poppnn/minikb/enclosure/variants/2_touches_batterie/png/back_usb.png

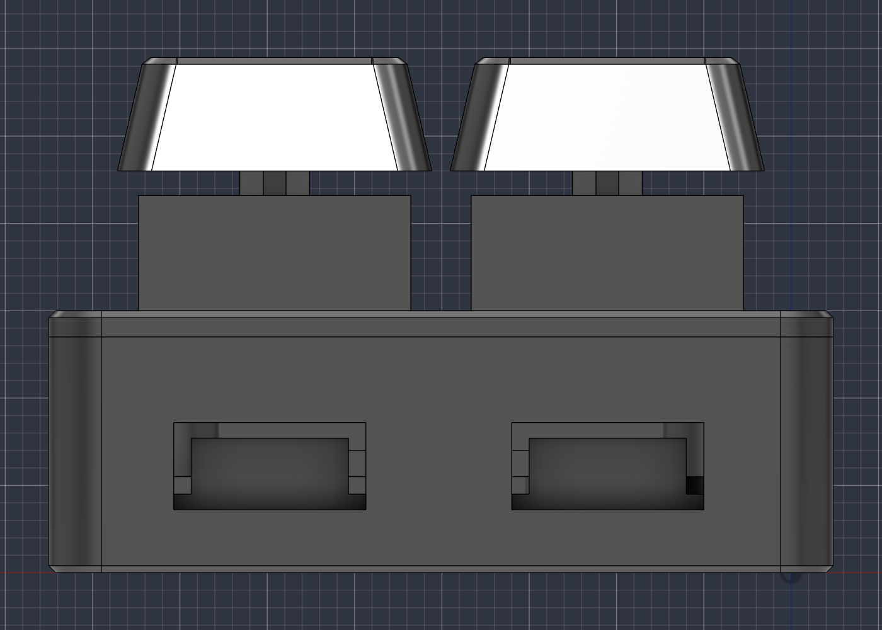
enclosure/variants/2_touches_batterie/png/back_usb.png
