poppnn/minikb/enclosure/variants/2_touches_batterie/png/bottom.png

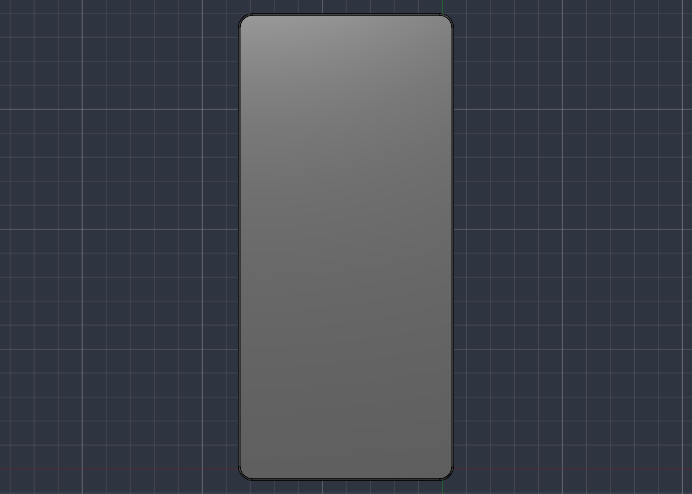
enclosure/variants/2_touches_batterie/png/bottom.png
