poppnn/minikb/enclosure/variants/2_touches_batterie/png/case_inside_iso.png

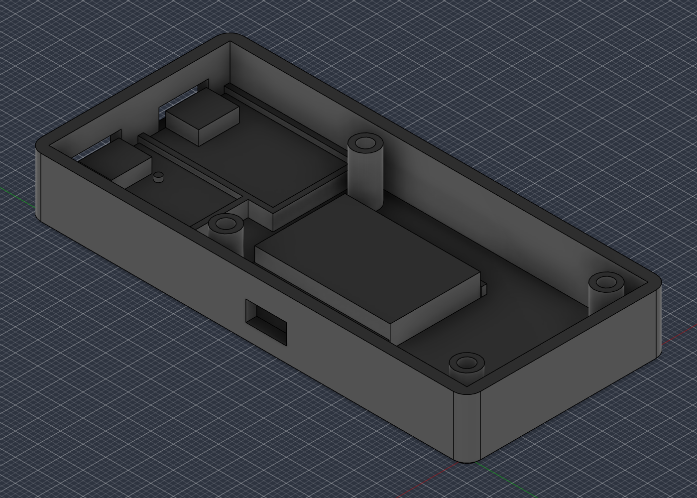
enclosure/variants/2_touches_batterie/png/case_inside_iso.png
