poppnn/minikb/enclosure/variants/2_touches_batterie/png/exploded_iso.png

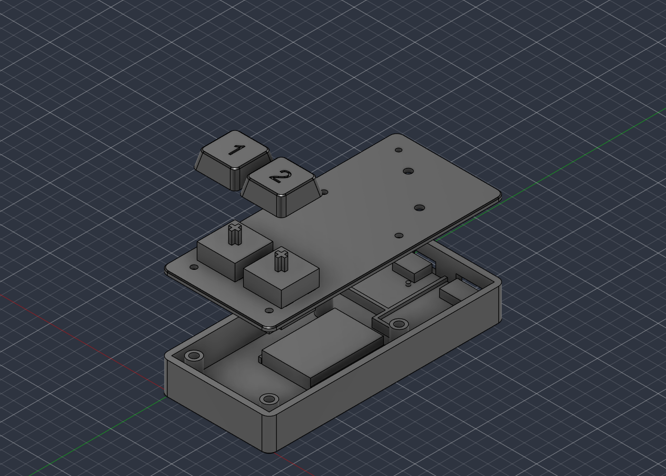
enclosure/variants/2_touches_batterie/png/exploded_iso.png
