poppnn/minikb/enclosure/variants/4_touches/png/back_usb.png

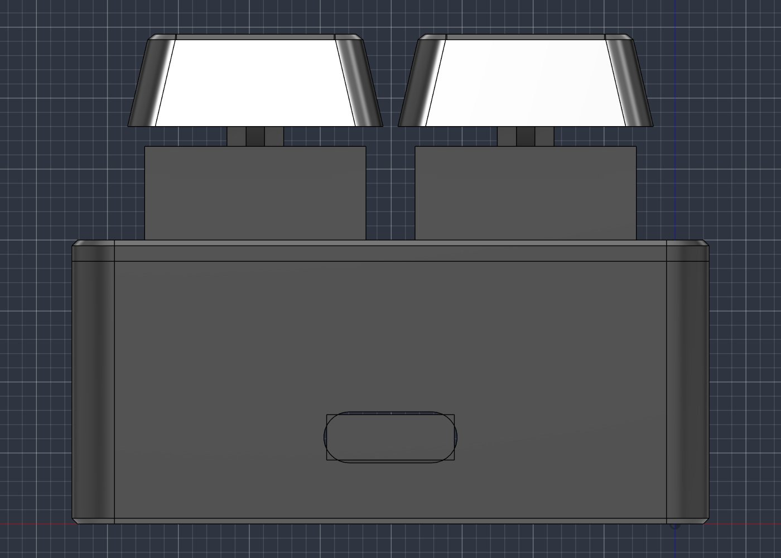
enclosure/variants/4_touches/png/back_usb.png
