poppnn/minikb/enclosure/variants/4_touches/png/bottom.png

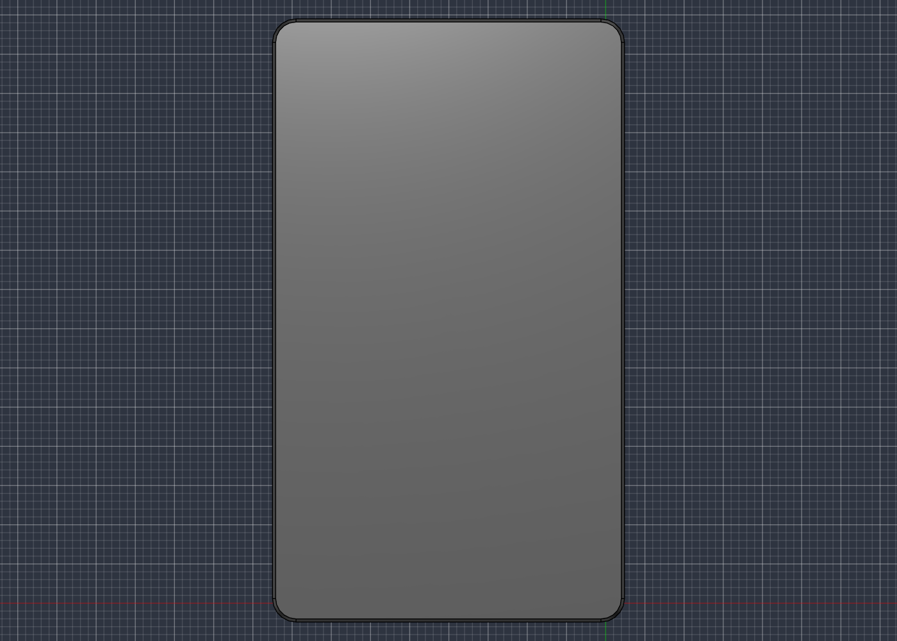
enclosure/variants/4_touches/png/bottom.png
