poppnn/minikb/enclosure/variants/4_touches/png/case_inside_top.png

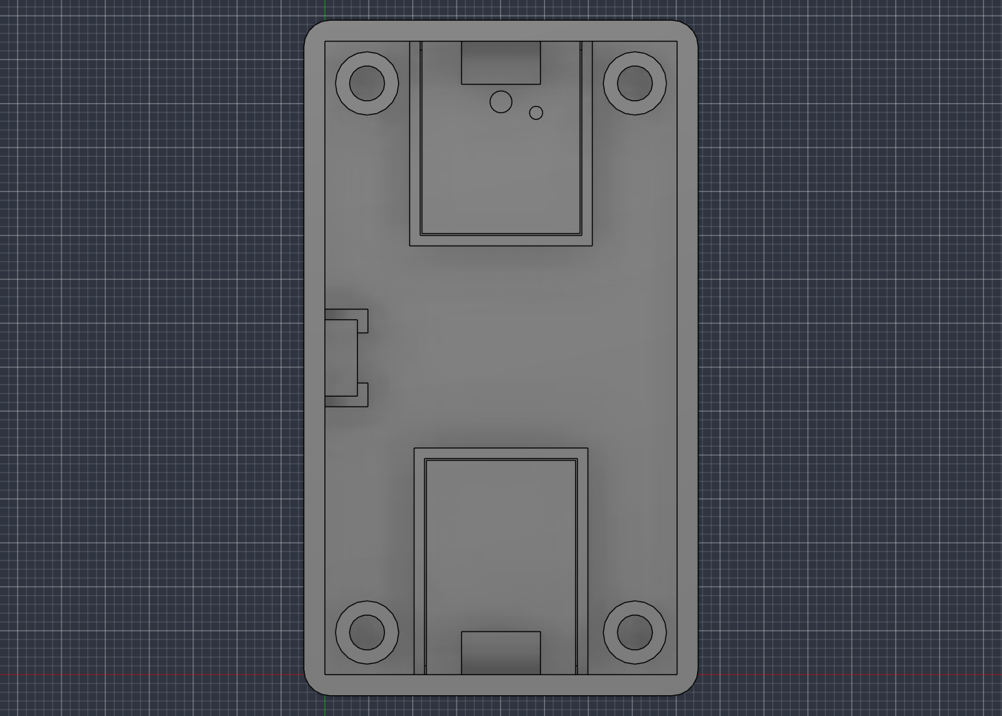
enclosure/variants/4_touches/png/case_inside_top.png
