poppnn/minikb/enclosure/variants/4_touches/png/exploded_iso.png

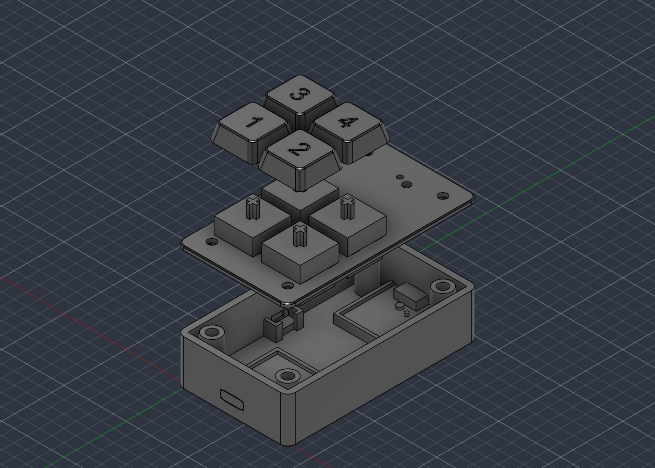
enclosure/variants/4_touches/png/exploded_iso.png
