poppnn/minikb/enclosure/variants/4_touches/png/top.png

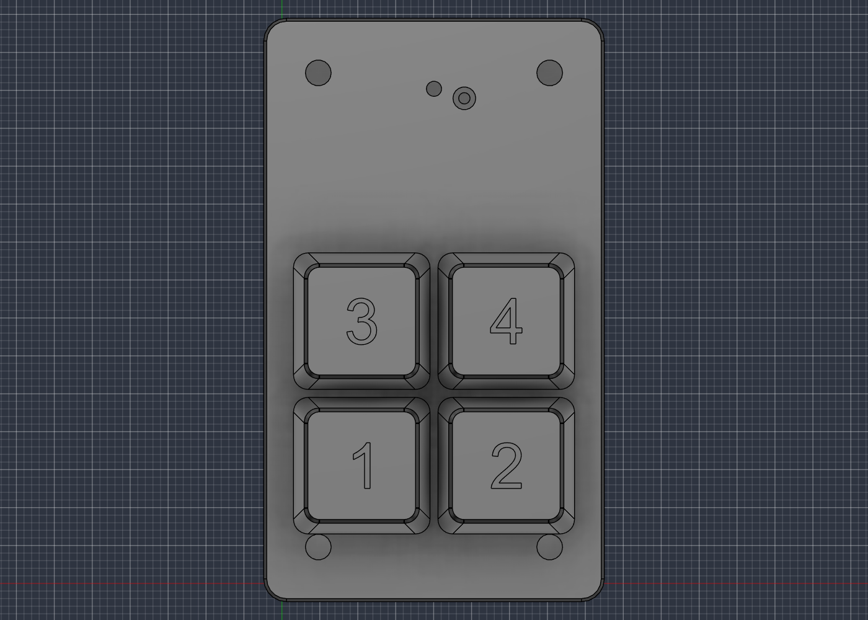
enclosure/variants/4_touches/png/top.png
