poppnn/minikb/enclosure/variants/4_touches_batterie/png/case_inside_iso.png

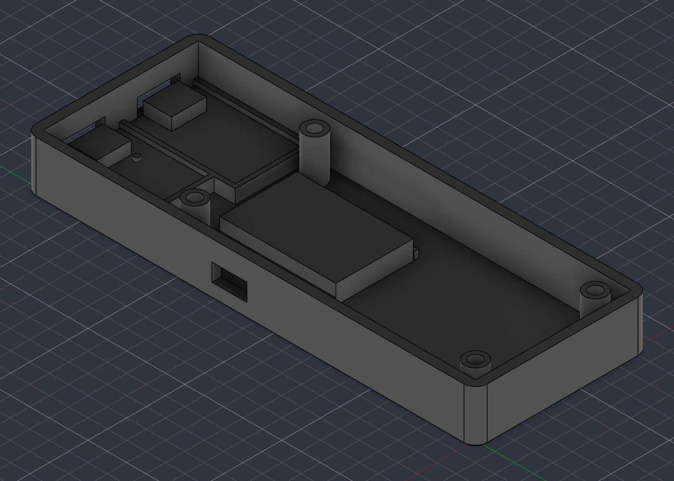
enclosure/variants/4_touches_batterie/png/case_inside_iso.png
