poppnn/minikb/enclosure/variants/4_touches_batterie/png/exploded_iso.png

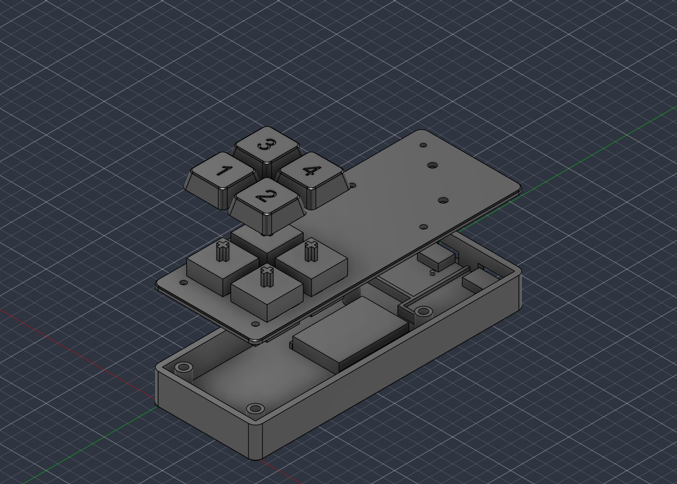
enclosure/variants/4_touches_batterie/png/exploded_iso.png
