poppnn/minikb/enclosure/variants/6_touches_batterie/png/case_inside_iso.png

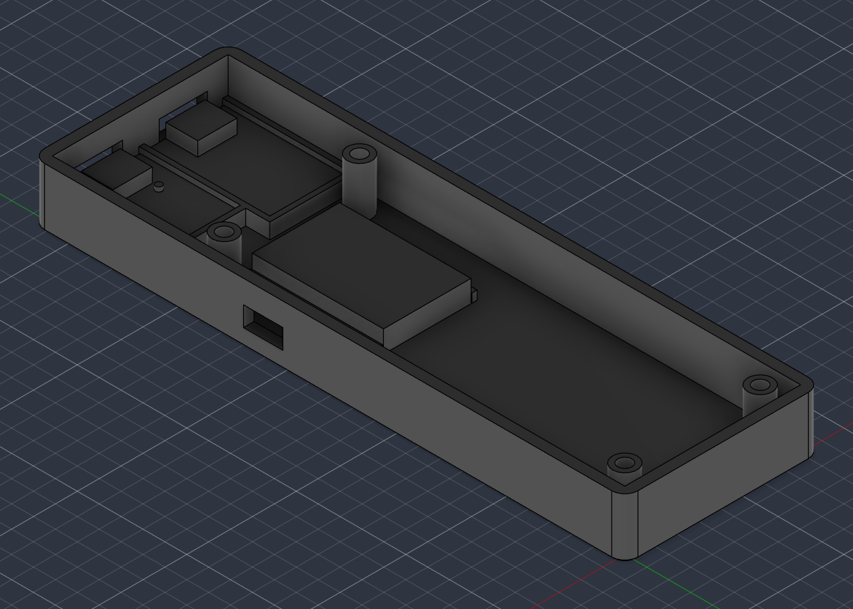
enclosure/variants/6_touches_batterie/png/case_inside_iso.png
