poppnn/minikb/enclosure/variants/6_touches_batterie/png/exploded_iso.png

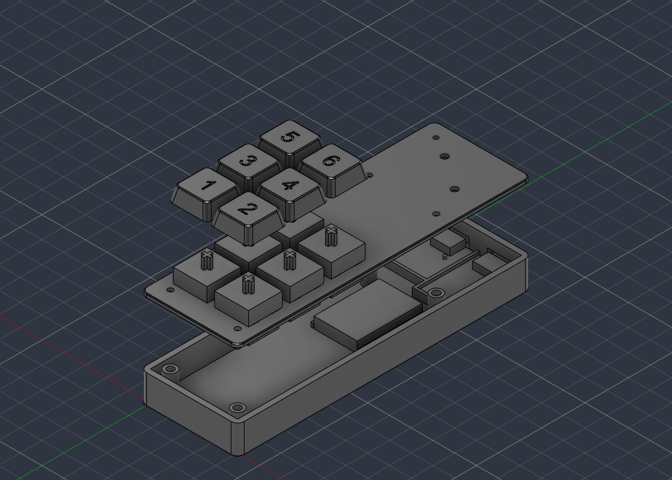
enclosure/variants/6_touches_batterie/png/exploded_iso.png
