poppnn/minikb/enclosure/variants/8_touches_batterie/png/case_inside_iso.png

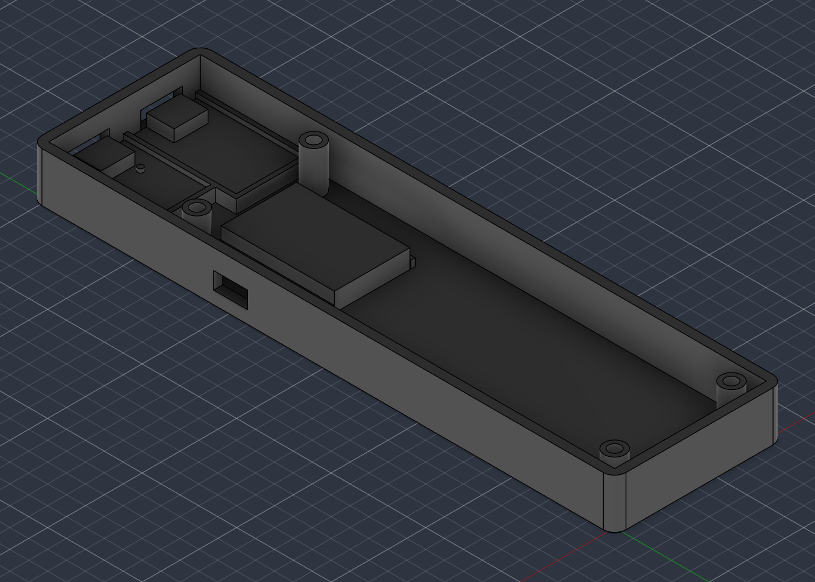
enclosure/variants/8_touches_batterie/png/case_inside_iso.png
