poppnn/minikb/enclosure/variants/8_touches_batterie/png/exploded_iso.png

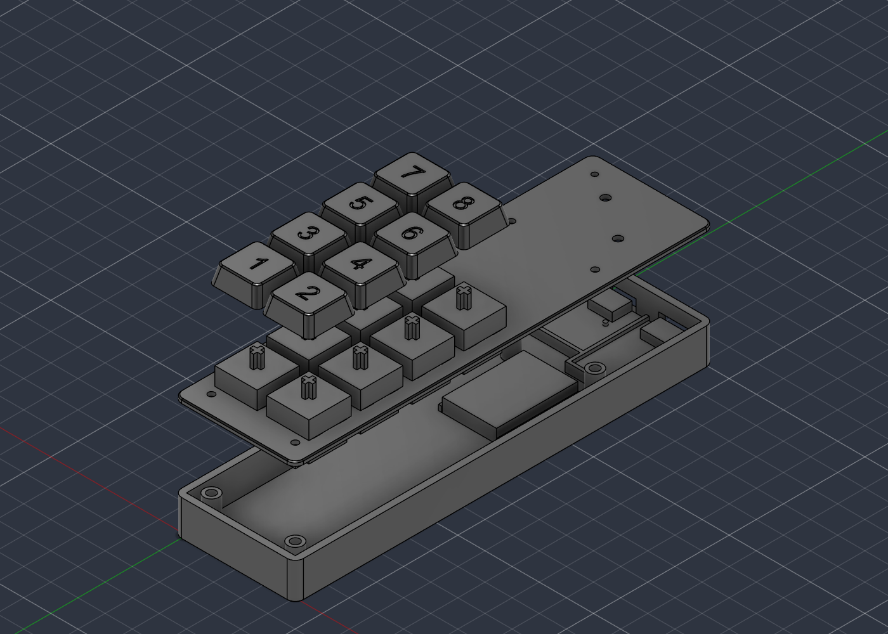
enclosure/variants/8_touches_batterie/png/exploded_iso.png
