poppnn/minikb/enclosure/stl/assembly.stl

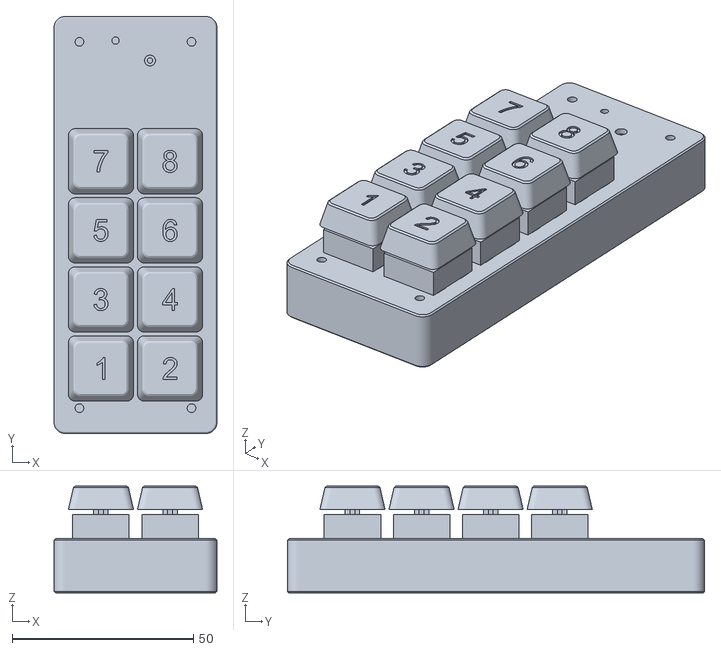
[picture p17: CAD file, 2026-11-04]
enclosure/stl/assembly.stl
44.9 x 115.0 x 29.5
