poppnn/minikb/enclosure/variants/4_touches/stl/assembly.stl

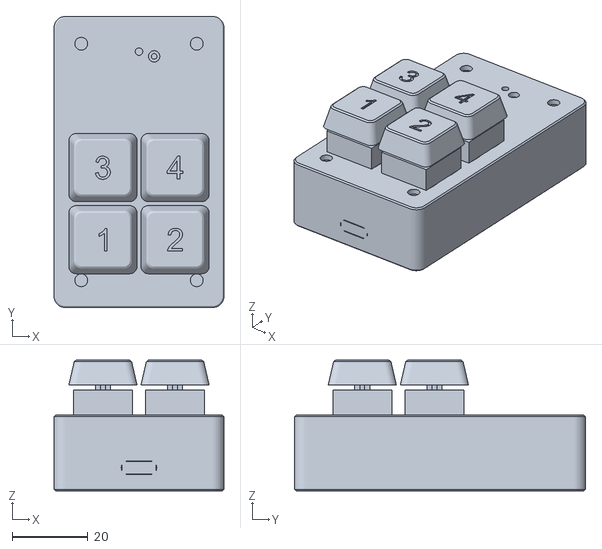
[picture p18: CAD file, 2026-11-05]
enclosure/variants/4_touches/stl/assembly.stl
44.9 x 76.9 x 34.5
