poppnn/minikb/enclosure/variants/6_touches_batterie/stl/assembly.stl

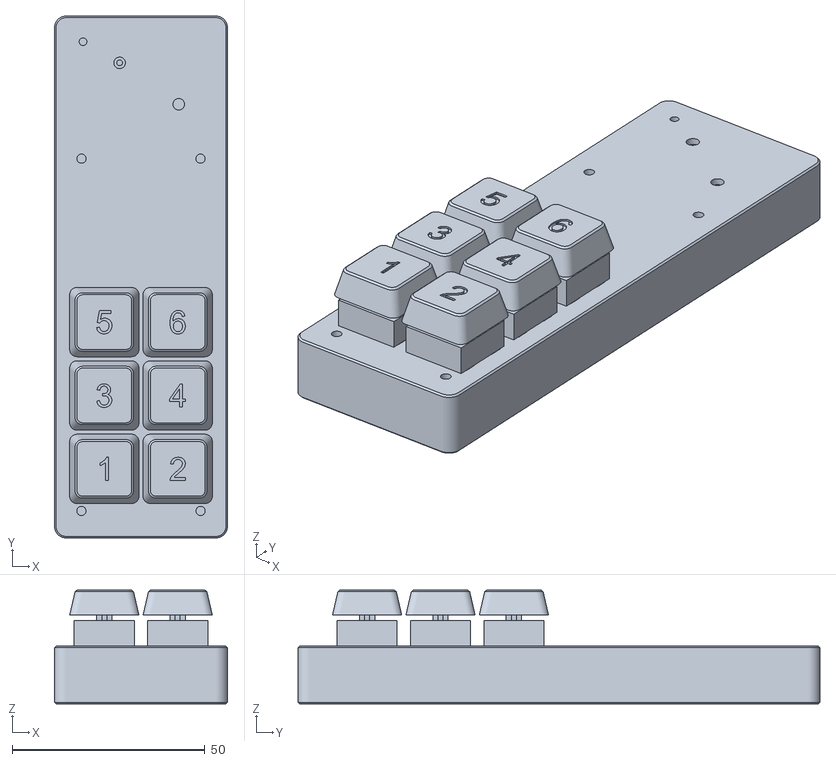
[picture p19: CAD file, 2026-11-04]
enclosure/variants/6_touches_batterie/stl/assembly.stl
44.9 x 135.5 x 29.5
