poppnn/minikb/enclosure/variants/2_touches/stl/assembly.stl

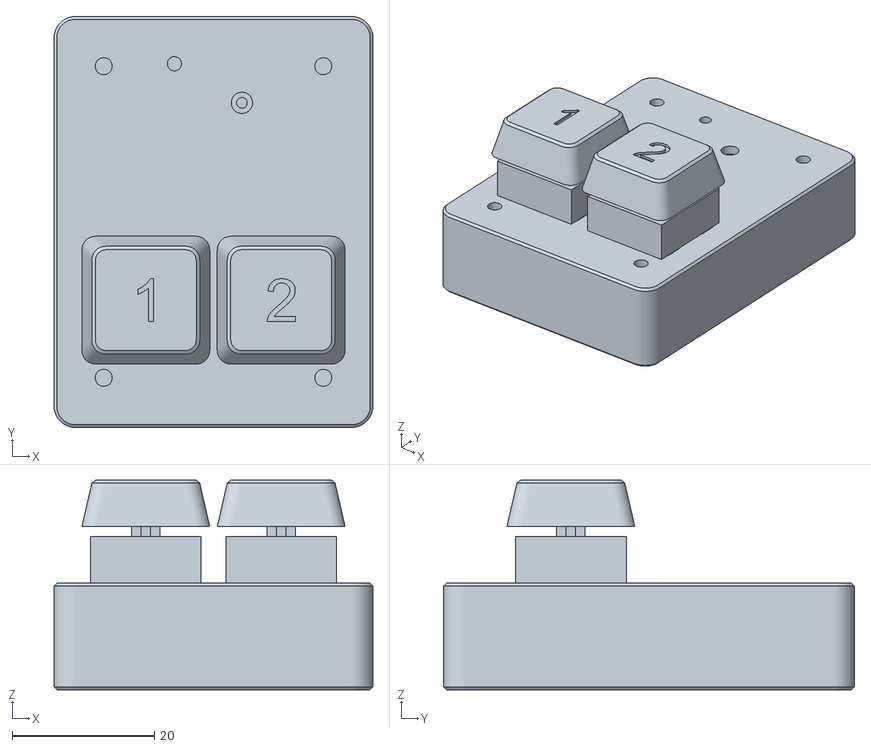
[picture p20: CAD file, 2026-11-04]
enclosure/variants/2_touches/stl/assembly.stl
44.9 x 57.9 x 29.5
