poppnn/minikb/enclosure/variants/2_touches_batterie/stl/assembly.stl

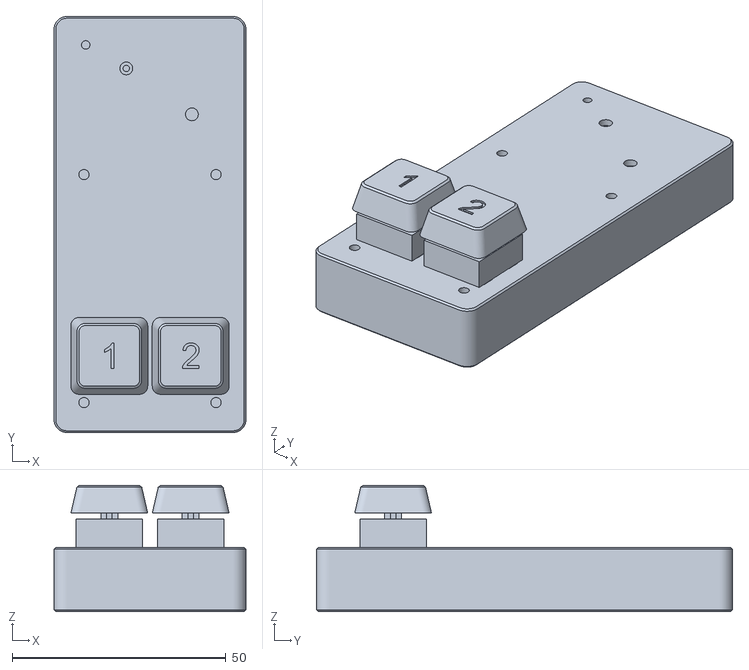
[picture p21: CAD file, 2026-11-04]
enclosure/variants/2_touches_batterie/stl/assembly.stl
44.9 x 97.3 x 29.5
