poppnn/minikb/enclosure/variants/6_touches/stl/assembly.stl

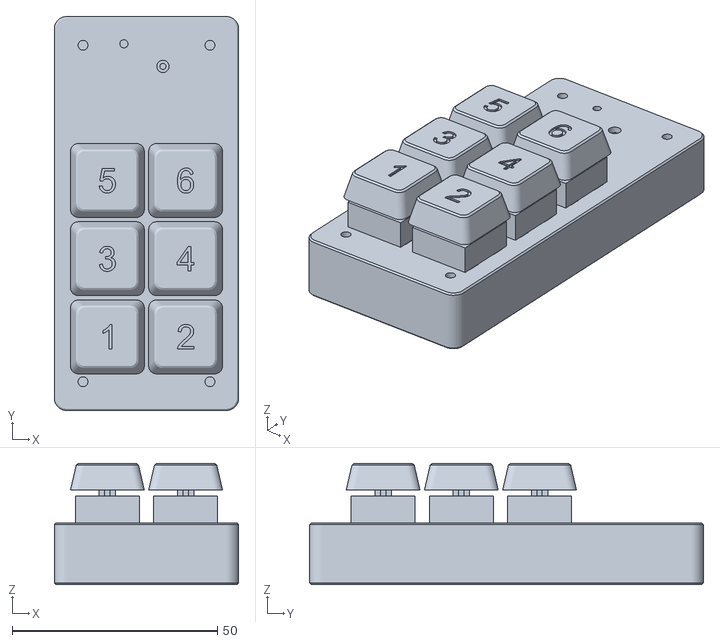
[picture p22: CAD file, 2026-11-04]
enclosure/variants/6_touches/stl/assembly.stl
44.9 x 96.0 x 29.5
