poppnn/minikb/enclosure/variants/8_touches_batterie/stl/assembly.stl

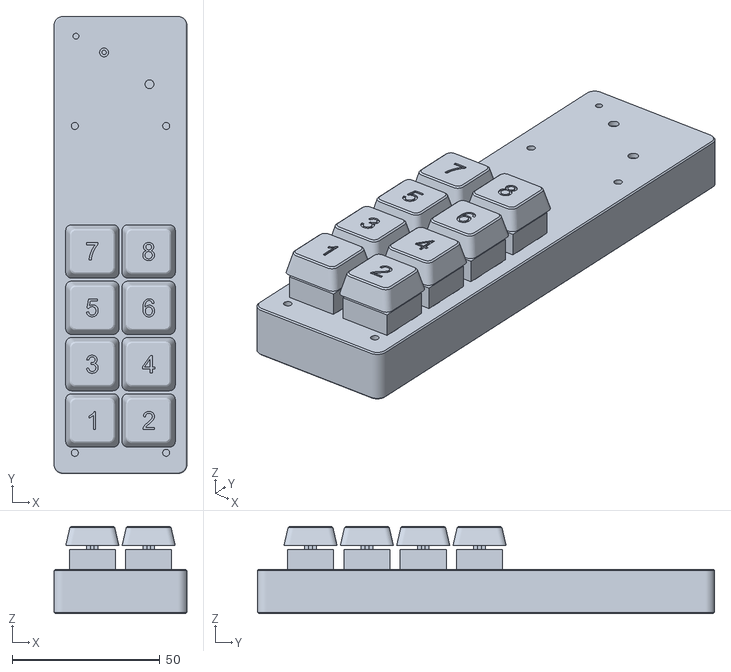
[picture p23: CAD file, 2026-11-04]
enclosure/variants/8_touches_batterie/stl/assembly.stl
44.9 x 154.5 x 29.5
