poppnn/minikb/enclosure/variants/4_touches_batterie/stl/assembly.stl

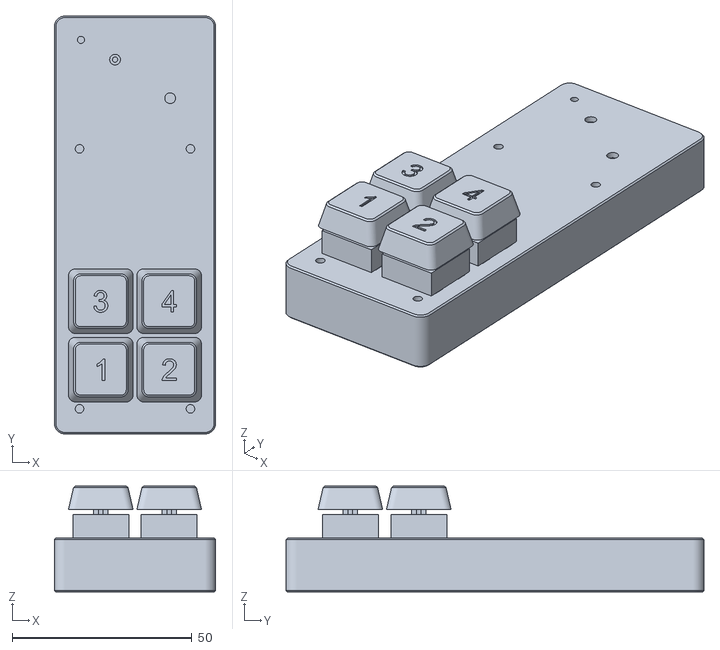
[picture p24: CAD file, 2026-11-04]
enclosure/variants/4_touches_batterie/stl/assembly.stl
44.9 x 116.4 x 29.5
