poppnn/minikb/enclosure/variants/2_touches_batterie/stl/case.stl

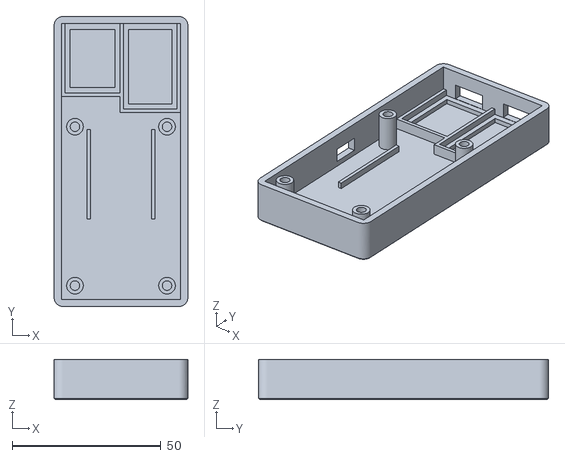
[picture p25: CAD file, 2026-11-04]
enclosure/variants/2_touches_batterie/stl/case.stl
44.9 x 97.3 x 13.5
