poppnn/minikb/enclosure/variants/4_touches/stl/plate.stl

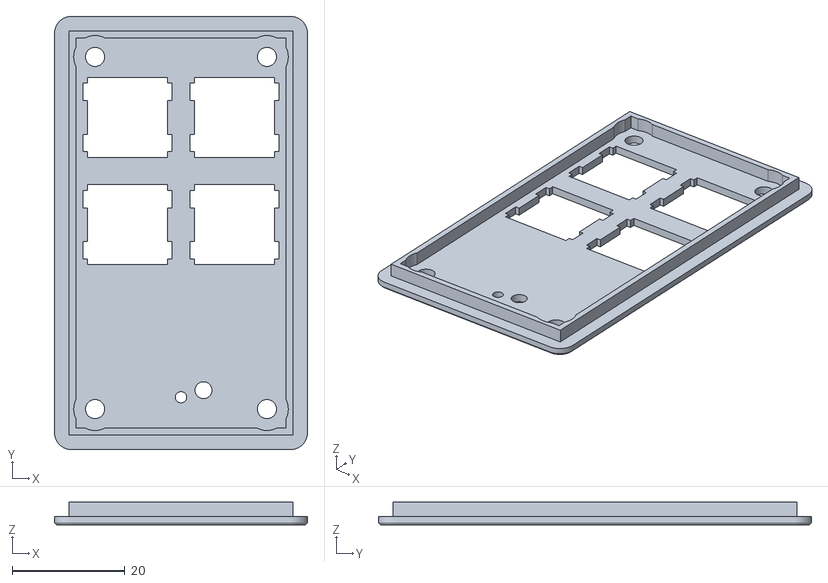
[picture p26: CAD file, 2026-11-05]
enclosure/variants/4_touches/stl/plate.stl
44.9 x 76.9 x 4.00
