poppnn/minikb/enclosure/variants/4_touches_batterie/stl/plate.stl

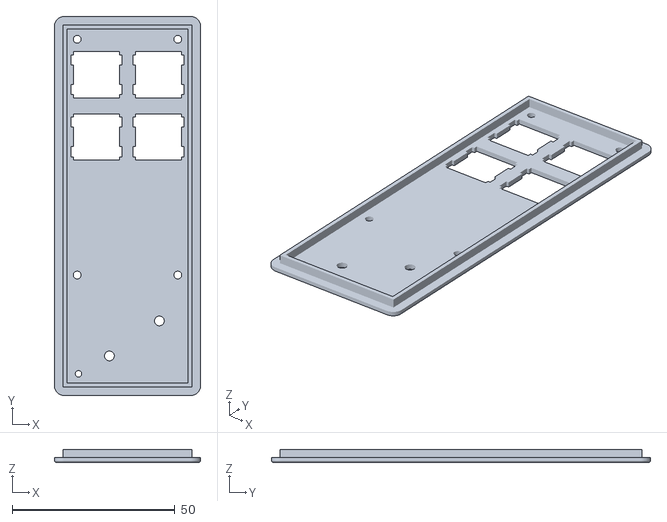
[picture p27: CAD file, 2026-11-04]
enclosure/variants/4_touches_batterie/stl/plate.stl
44.9 x 116.4 x 4.00
