poppnn/minikb/enclosure/variants/6_touches_batterie/stl/keycap_6.stl

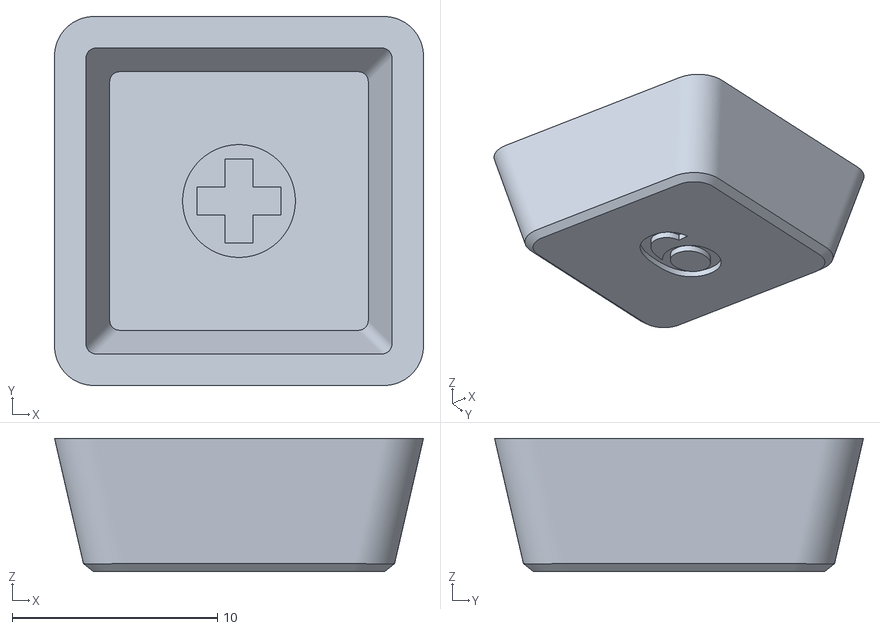
[picture p28: CAD file, 2026-11-04]
enclosure/variants/6_touches_batterie/stl/keycap_6.stl
18.0 x 18.0 x 6.50
