poppnn/minikb/enclosure/variants/4_touches/stl/case.stl

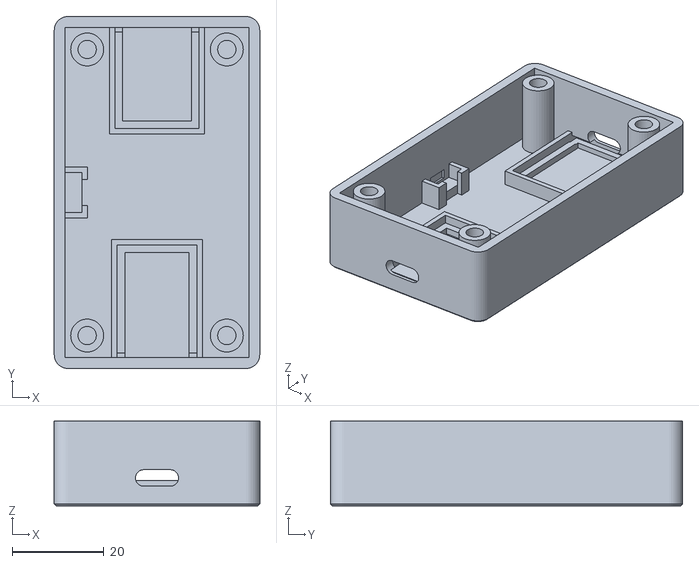
[picture p29: CAD file, 2026-11-05]
enclosure/variants/4_touches/stl/case.stl
44.9 x 76.9 x 18.5
