poppnn/minikb/enclosure/variants/2_touches_batterie/stl/plate.stl

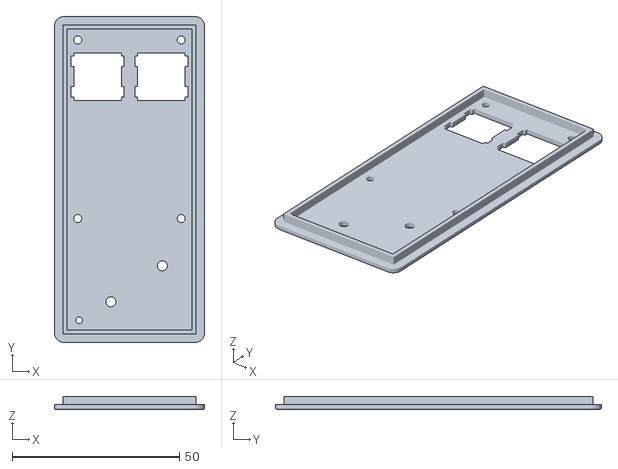
[picture p30: CAD file, 2026-11-04]
enclosure/variants/2_touches_batterie/stl/plate.stl
44.9 x 97.3 x 4.00
