poppnn/minikb/enclosure/variants/2_touches_batterie/stl/keycap_2u.stl

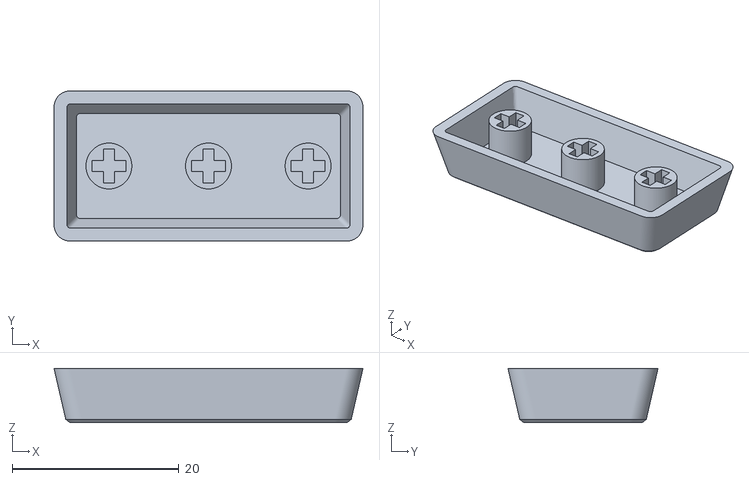
[picture p31: CAD file, 2026-11-04]
enclosure/variants/2_touches_batterie/stl/keycap_2u.stl
37.0 x 18.0 x 6.50
