poppnn/minikb/enclosure/variants/8_touches_batterie/stl/case.stl

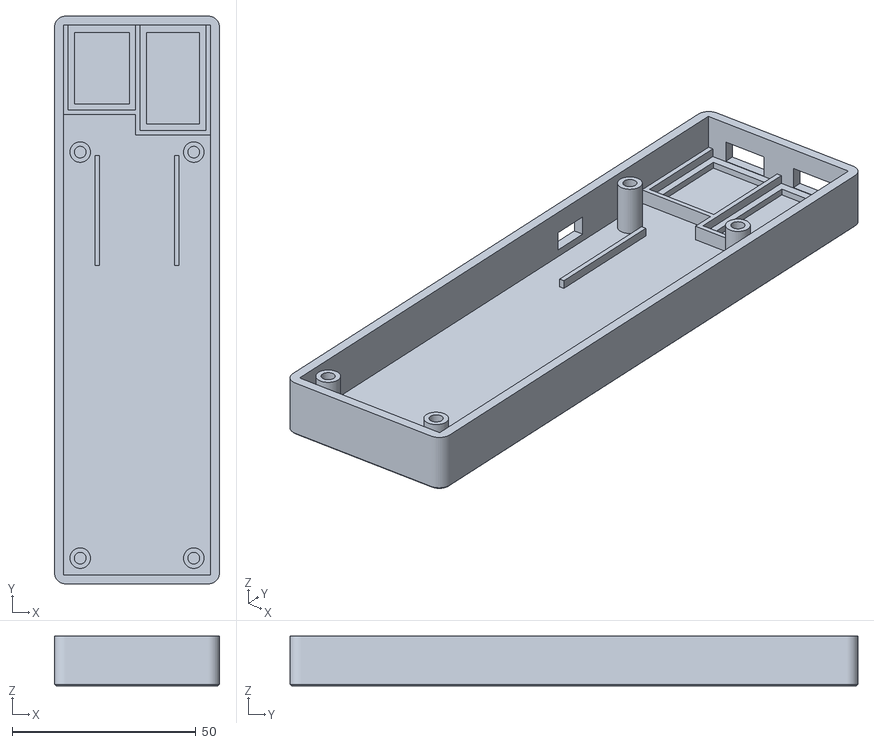
[picture p32: CAD file, 2026-11-04]
enclosure/variants/8_touches_batterie/stl/case.stl
44.9 x 154.5 x 13.5
