poppnn/minikb/enclosure/variants/4_touches_batterie/stl/case.stl

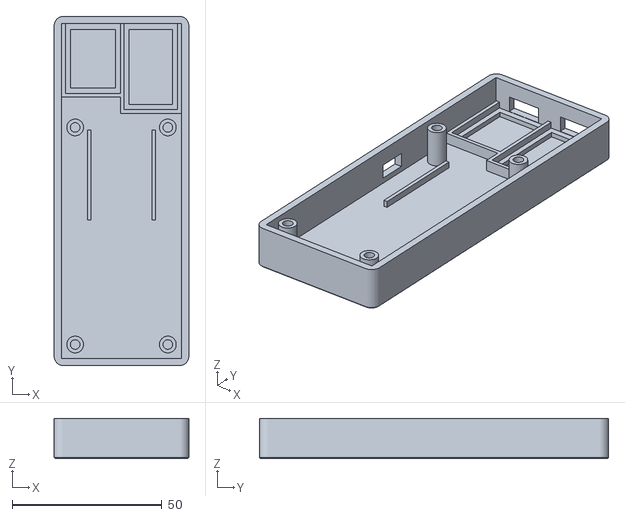
[picture p33: CAD file, 2026-11-04]
enclosure/variants/4_touches_batterie/stl/case.stl
44.9 x 116.4 x 13.5
