poppnn/minikb/enclosure/variants/6_touches_batterie/stl/case.stl

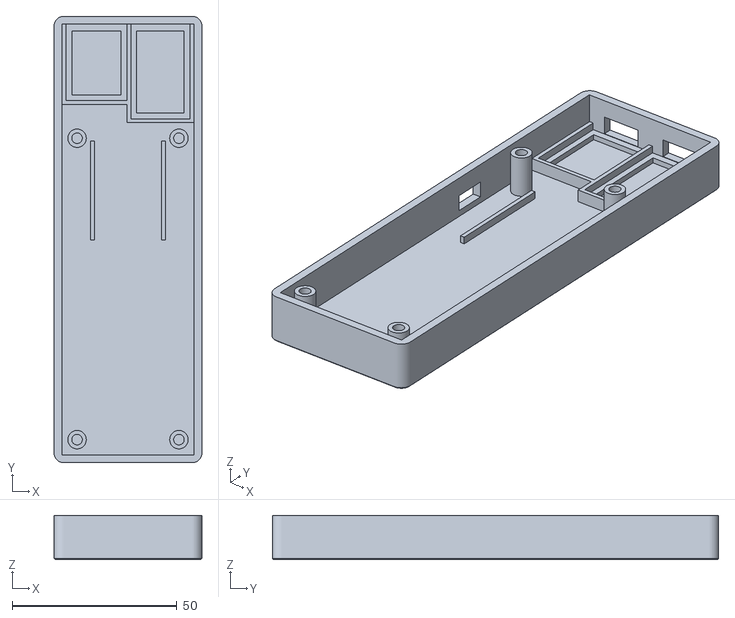
[picture p34: CAD file, 2026-11-04]
enclosure/variants/6_touches_batterie/stl/case.stl
44.9 x 135.4 x 13.5
