poppnn/minikb/enclosure/variants/8_touches_batterie/stl/plate.stl

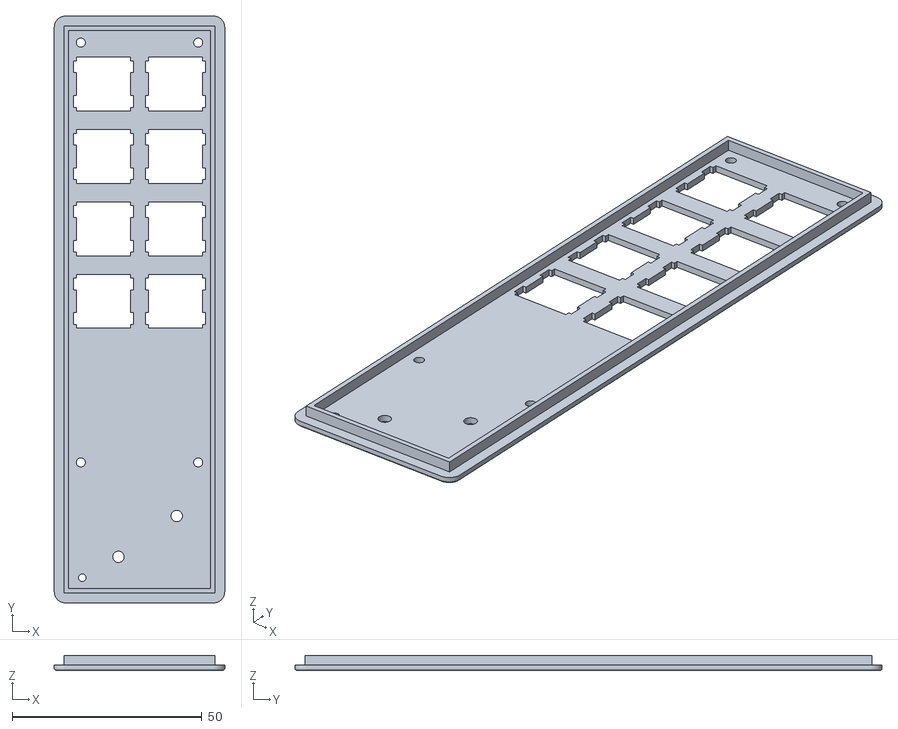
[picture p35: CAD file, 2026-11-04]
enclosure/variants/8_touches_batterie/stl/plate.stl
44.9 x 154.5 x 4.00
