poppnn/minikb/enclosure/variants/6_touches_batterie/stl/plate.stl

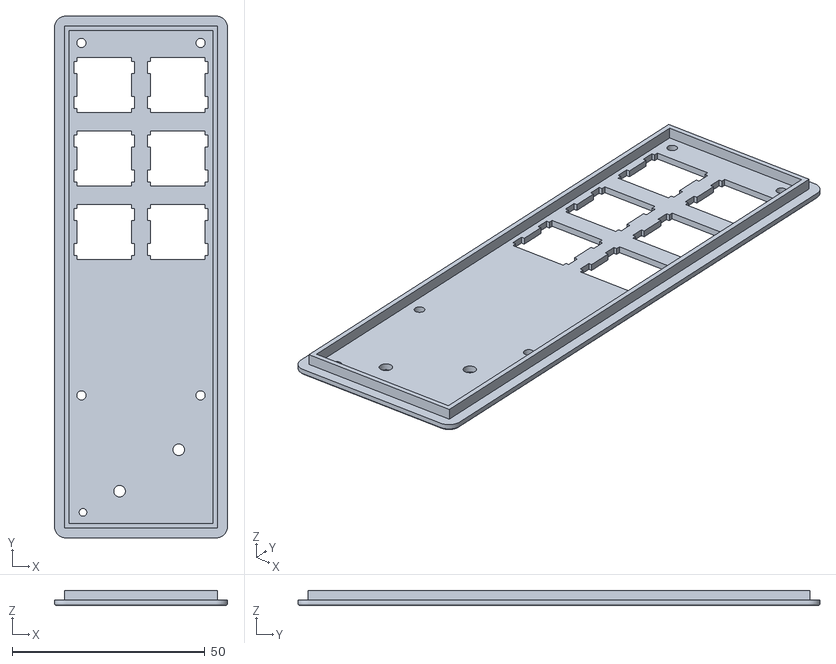
[picture p36: CAD file, 2026-11-04]
enclosure/variants/6_touches_batterie/stl/plate.stl
44.9 x 135.4 x 4.00
