poppnn/minikb/(list of files, cad)

Other CAD files:
enclosure/variants/8_touches_batterie/stl/keycap_5.stl
enclosure/variants/2_touches_batterie/stl/keycap_1.stl
enclosure/variants/4_touches_batterie/stl/keycap_1.stl
enclosure/variants/6_touches_batterie/stl/keycap_5.stl
enclosure/variants/8_touches_batterie/stl/keycap_3.stl
enclosure/variants/4_touches_batterie/stl/keycap_4.stl
enclosure/variants/6_touches_batterie/stl/keycap_1.stl
enclosure/variants/8_touches_batterie/stl/keycap_2.stl
enclosure/variants/4_touches/stl/keycap_3.stl
enclosure/variants/4_touches/stl/keycap_1.stl
enclosure/variants/4_touches_batterie/stl/keycap_2.stl
enclosure/variants/6_touches_batterie/stl/keycap_4.stl
enclosure/variants/2_touches_batterie/stl/keycap_2.stl
enclosure/variants/4_touches/stl/keycap_2u.stl
enclosure/variants/4_touches_batterie/stl/keycap_3.stl
enclosure/variants/6_touches_batterie/stl/keycap_2.stl
enclosure/variants/4_touches/stl/keycap_4.stl
enclosure/variants/6_touches_batterie/stl/keycap_3.stl
enclosure/variants/8_touches_batterie/stl/keycap_8.stl
enclosure/variants/4_touches/stl/keycap_2.stl
enclosure/variants/8_touches_batterie/stl/keycap_4.stl
enclosure/variants/8_touches_batterie/stl/keycap_1.stl
enclosure/variants/8_touches_batterie/stl/keycap_7.stl
enclosure/minikb.f3d
enclosure/stl/case.stl
enclosure/stl/keycap_1.stl
enclosure/stl/keycap_2.stl
enclosure/stl/keycap_2u.stl
enclosure/stl/keycap_3.stl
enclosure/stl/keycap_4.stl
enclosure/stl/keycap_5.stl
enclosure/stl/keycap_6.stl
enclosure/stl/keycap_7.stl
enclosure/stl/keycap_8.stl
enclosure/stl/plate.stl
enclosure/variants/2_touches/stl/case.stl
enclosure/variants/2_touches/stl/keycap_1.stl
enclosure/variants/2_touches/stl/keycap_2.stl
enclosure/variants/2_touches/stl/keycap_2u.stl
enclosure/variants/2_touches/stl/plate.stl
enclosure/variants/6_touches/stl/case.stl
enclosure/variants/6_touches/stl/keycap_1.stl
enclosure/variants/6_touches/stl/keycap_2.stl
enclosure/variants/6_touches/stl/keycap_2u.stl
enclosure/variants/6_touches/stl/keycap_3.stl
enclosure/variants/6_touches/stl/keycap_4.stl
enclosure/variants/6_touches/stl/keycap_5.stl
enclosure/variants/6_touches/stl/keycap_6.stl
enclosure/variants/6_touches/stl/plate.stl
enclosure/variants/8_touches/stl/case.stl
enclosure/variants/8_touches/stl/keycap_1.stl
enclosure/variants/8_touches/stl/keycap_2.stl
enclosure/variants/8_touches/stl/keycap_2u.stl
enclosure/variants/8_touches/stl/keycap_3.stl
enclosure/variants/8_touches/stl/keycap_4.stl
enclosure/variants/8_touches/stl/keycap_5.stl
enclosure/variants/8_touches/stl/keycap_6.stl
enclosure/variants/8_touches/stl/keycap_7.stl
enclosure/variants/8_touches/stl/keycap_8.stl
enclosure/variants/8_touches/stl/plate.stl
