poppnn/minikb/enclosure/variants/2_touches_batterie/png/assembly_iso.png

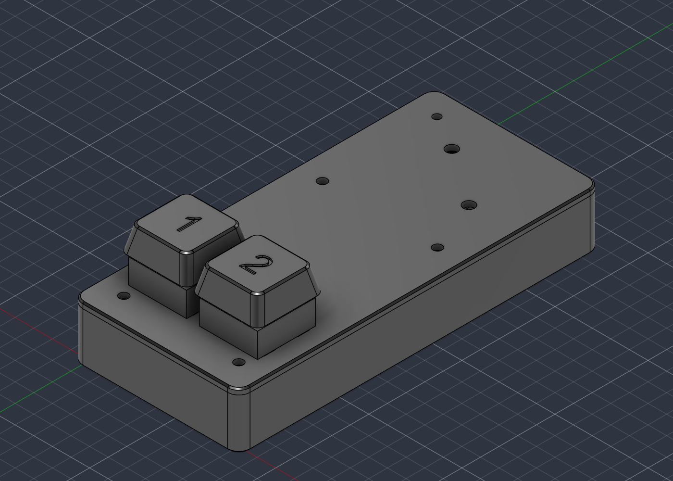
enclosure/variants/2_touches_batterie/png/assembly_iso.png
