poppnn/minikb/enclosure/variants/4_touches/png/assembly_iso.png

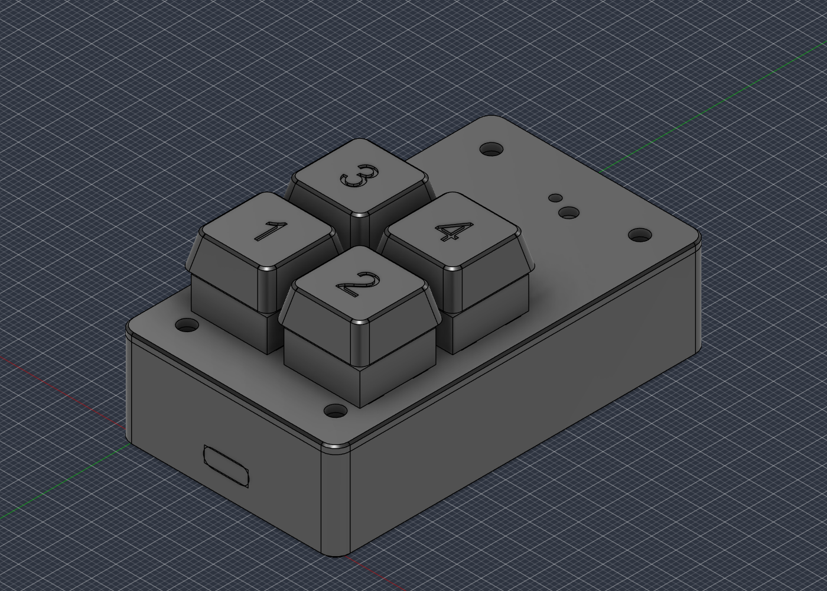
enclosure/variants/4_touches/png/assembly_iso.png
