poppnn/minikb/enclosure/variants/4_touches_batterie/png/assembly_iso.png

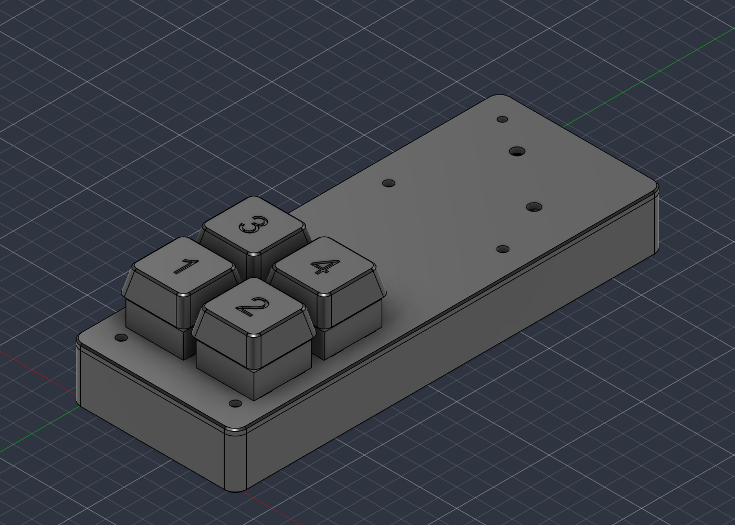
enclosure/variants/4_touches_batterie/png/assembly_iso.png
