poppnn/minikb/enclosure/variants/6_touches_batterie/png/assembly_iso.png

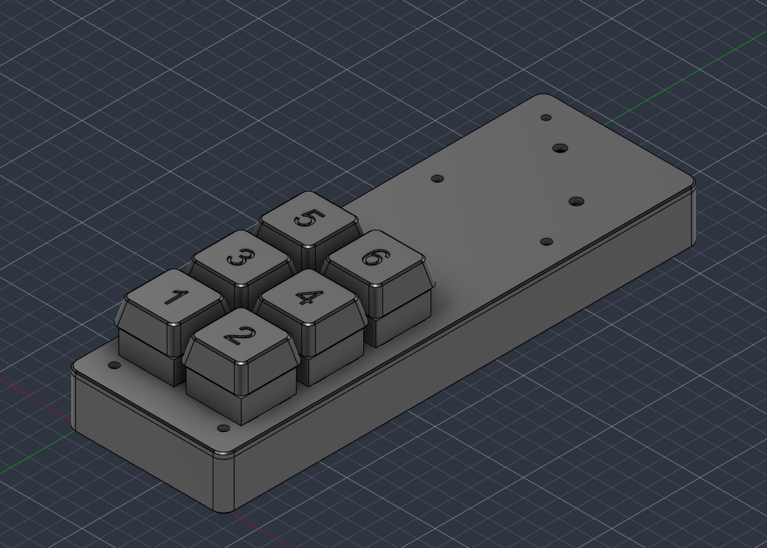
enclosure/variants/6_touches_batterie/png/assembly_iso.png
