poppnn/minikb/src/main.cpp

// MiniKB : clavier de macros BLE. Mode normal = BLE HID, mode config = Wi-Fi AP + web UI.
#include <Arduino.h>
#include <WiFi.h>
#include <esp_attr.h>
#include "ble_hid.h"
#include "buttons.h"
#include "config.h"
#include "power.h"
#include "webserver.h"

static constexpr uint32_t BOOT_LONG_PRESS_MS = 3000;
static constexpr uint32_t CONFIG_MAGIC = 0xC0F16A11;

// Survit à ESP.restart() : demande de démarrage en mode config.
RTC_NOINIT_ATTR static uint32_t bootRequest;

static Config cfg;
static bool configMode = false;
static std::vector<Button> keys;
static Button bootButton;

static void setLed(bool on) { digitalWrite(LED_PIN, on != LED_ACTIVE_LOW); }

static void updateLed(uint32_t now) {
    if (configMode) setLed((now / 100) % 2);          // flash rapide
    else if (hidConnected()) setLed(true);             // fixe
    else setLed((now / 500) % 2);                      // clignote
}

static void sendKey(const KeyConfig& k) {
    std::vector<uint32_t> bad;
    auto strokes = textToStrokes(k.send.c_str(), cfg.layout, &bad);
    for (uint32_t cp : bad)
        Serial.printf("[keymap] caractère non supporté U+%04X \"%s\" ignoré\n", unsigned(cp), codepointToUtf8(cp).c_str());
    if (k.enter) strokes.push_back({0, KEY_ENTER});
    hidQueue(strokes);
}

// Port série : un caractère affiche l'état (les logs de boot sont souvent perdus en USB CDC),
// « c » redémarre en mode config, « n » en mode normal.
static void printStatus() {
    Serial.printf("[status] mode %s, BLE %s, %u touche(s), layout %s, AP \"%s\" %s, appareils Wi-Fi %u, "
                  "uptime %lus, dernier reset %d, RAM libre %u\n",
                  configMode ? "config" : "normal", hidConnected() ? "connecté" : "en attente",
                  unsigned(cfg.keys.size()), cfg.layout == Layout::FR ? "fr" : "us", AP_SSID,
                  cfg.apPass.isEmpty() ? "ouvert" : ("mot de passe \"" + cfg.apPass + "\"").c_str(),
                  configMode ? unsigned(WiFi.softAPgetStationNum()) : 0u, millis() / 1000UL,
                  int(esp_reset_reason()), unsigned(ESP.getFreeHeap()));
}

static void handleSerial() {
    int cmd = 0;
    while (Serial.available()) cmd = Serial.read();
    if (cmd == 'c' || cmd == 'n') {
        Serial.printf("[main] redémarrage en mode %s\n", cmd == 'c' ? "config" : "normal");
        Serial.flush();
        bootRequest = cmd == 'c' ? CONFIG_MAGIC : 0;
        ESP.restart();
    }
    printStatus();
}

void setup() {
    // 80 MHz suffit au BLE et au Wi-Fi, et consomme moins que les 160 MHz par défaut.
    setCpuFrequencyMhz(80);
    Serial.begin(115200);
    // L'USB CDC se réénumère au reset : laisse 2 s au terminal pour se reconnecter, sinon les logs (et le mot de passe AP) sont perdus.
    while (!Serial && millis() < 2000) {}
    pinMode(LED_PIN, OUTPUT);
    setLed(false);

    configMode = bootRequest == CONFIG_MAGIC;
    bootRequest = 0;

    if (!loadConfig(cfg)) Serial.println("[config] config par défaut utilisée");
    printStatus();

    if (configMode) {
        webBegin(cfg);
        return;
    }
    hidBegin(cfg.bleName.c_str());
    // Seuls les pins déclarés sont configurés ; les autres restent en entrée flottante.
    for (const KeyConfig& k : cfg.keys) {
        keys.emplace_back();
        keys.back().begin(k.pin);
    }
    bootButton.begin(BOOT_PIN);
    powerActivity(millis());
}

void loop() {
    uint32_t now = millis();
    updateLed(now);
    if (Serial.available()) handleSerial();
    if (configMode) {
        webLoop(now);
        delay(1);
        return;
    }

    if (bootButton.update(now, cfg.debounceMs, BOOT_LONG_PRESS_MS) == ButtonEvent::LongPress) {
        Serial.println("[main] BOOT maintenu 3 s : redémarrage en mode config");
        bootRequest = CONFIG_MAGIC;
        ESP.restart();
    }
    for (size_t i = 0; i < keys.size(); i++) {
        if (keys[i].update(now, cfg.debounceMs) == ButtonEvent::Pressed) {
            powerActivity(now);
            sendKey(cfg.keys[i]);
        }
    }
    hidLoop(now, cfg.keyDelayMs);
    powerLoop(cfg, now, hidBusy());
    // Rend la main à la tâche idle, qui met le CPU en attente d'interruption au lieu de tourner à vide.
    delay(1);
}
