poppnn/minikb/(commit log)

2026-11-04 MiniKB : clavier de macros BLE ESP32-C3, web UI, boîtier Fusion et web flasher
    Firmware PlatformIO (C3, S3 avec USB HID), table AZERTY/US testée en natif,
    web UI testée avec Playwright, modèle Fusion paramétrique (2/4/6/8 touches)
    avec STL, et web flasher ESP Web Tools déployé par GitHub Actions.
    [assembly.stl, case.stl, keycap_1.stl, keycap_2.stl, keycap_2u.stl, keycap_3.stl, keycap_4.stl, keycap_5.stl]
2026-11-04 Wi-Fi config : puissance 8,5 dBm, portail captif, délai tant qu'un appareil est connecté
    Le point d'accès de la C3 SuperMini décrochait. Ajoute aussi les commandes
    série c/n et l'état détaillé (reset, uptime, appareils, RAM).
    [main.cpp, webserver.cpp]
2026-11-04 Option batterie : TP4056 USB-C à côté de la SuperMini, petite LiPo 502030
    Les deux USB-C sortent côte à côte par la paroi arrière. La LiPo se pose entre
    les touches et les cartes (+39,5 mm au lieu de +73,5), les piliers arrière
    avancent. Variantes batterie 2/4/6/8 touches exportées. Le solveur d'esquisse
    pouvait placer une cote du mauvais côté de l'origine : vérifiée et corrigée.
    [assembly.stl, case.stl, keycap_1.stl, keycap_2.stl, keycap_2u.stl, keycap_3.stl, keycap_4.stl, keycap_5.stl]
2026-11-04 Boîtier 4 touches sans batterie : vis M3 x 14 vissées dans le plastique
    Plaque Ø 3,4, avant-trous Ø 2,6 profonds de 12,9 mm, piliers Ø 6,4 décalés
    de 0,2 mm. Les autres variantes gardent les M2 + inserts.
    [assembly.stl, case.stl, keycap_1.stl, keycap_2.stl, keycap_2u.stl, keycap_3.stl, keycap_4.stl, plate.stl]
2026-11-04 Boitier 4 touches : inserts M3, vis 14 mm, +5 mm, TP4056 en facade
    [assembly.stl, case.stl, plate.stl]
2026-11-04 Boitier 4 touches : prises USB-C a fleur, paroi ajustee autour
    [assembly.stl, case.stl, plate.stl]
2026-11-04 Boitier 4 touches : TP4056 26x17, SuperMini +1 mm, interrupteur lateral
    [assembly.stl, case.stl, keycap_1.stl, keycap_2.stl, keycap_2u.stl, keycap_3.stl, keycap_4.stl, plate.stl]
2026-11-05 Boitier 4 touches : interrupteur clipse dans un cadre, trou BOOT derriere l'USB-C
    [assembly.stl, case.stl, plate.stl]
